corygrant/WiperModule/PDF/WiperModule_v1_Schem.pdf

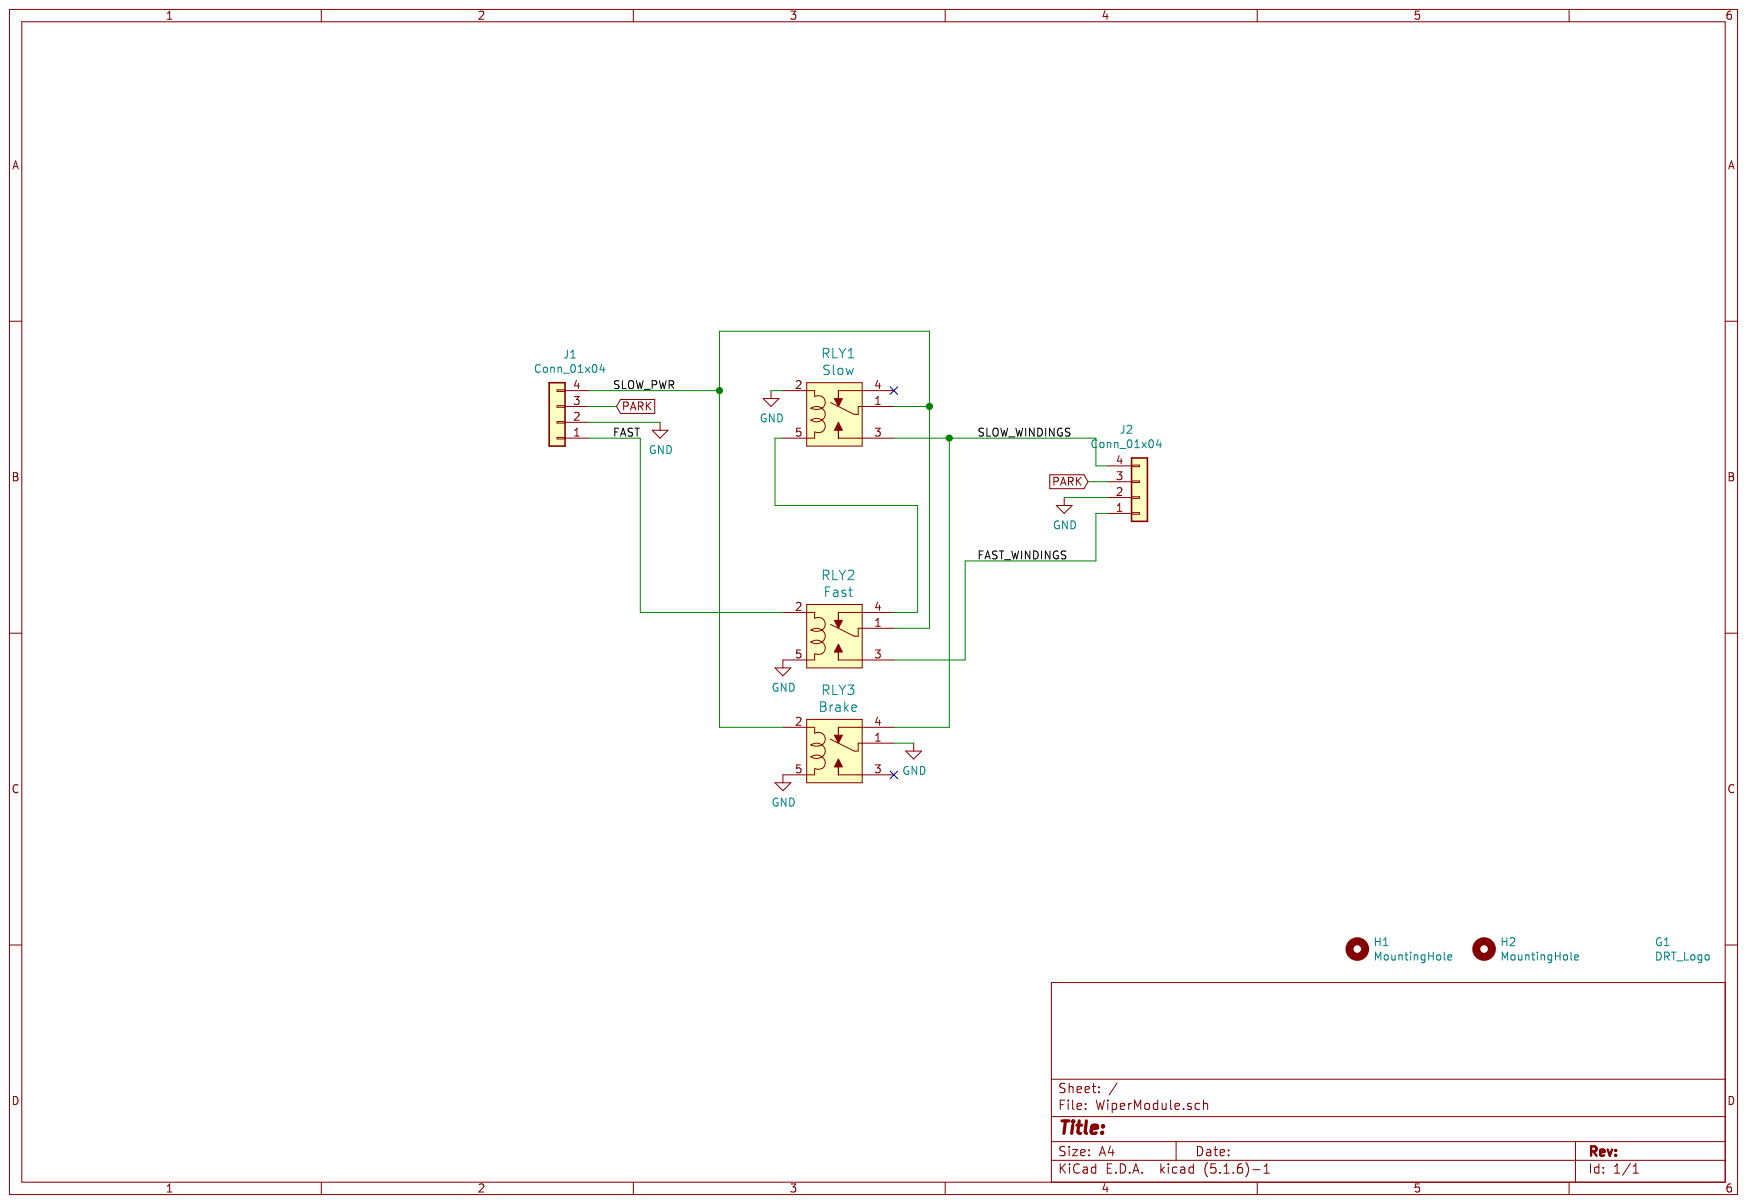
[picture p3: page 1]
