corygrant/WiperModule/WiperModule/WiperModule.kicad_pcb

## KiCad design WiperModule/WiperModule.kicad_pcb (2024-09-06)

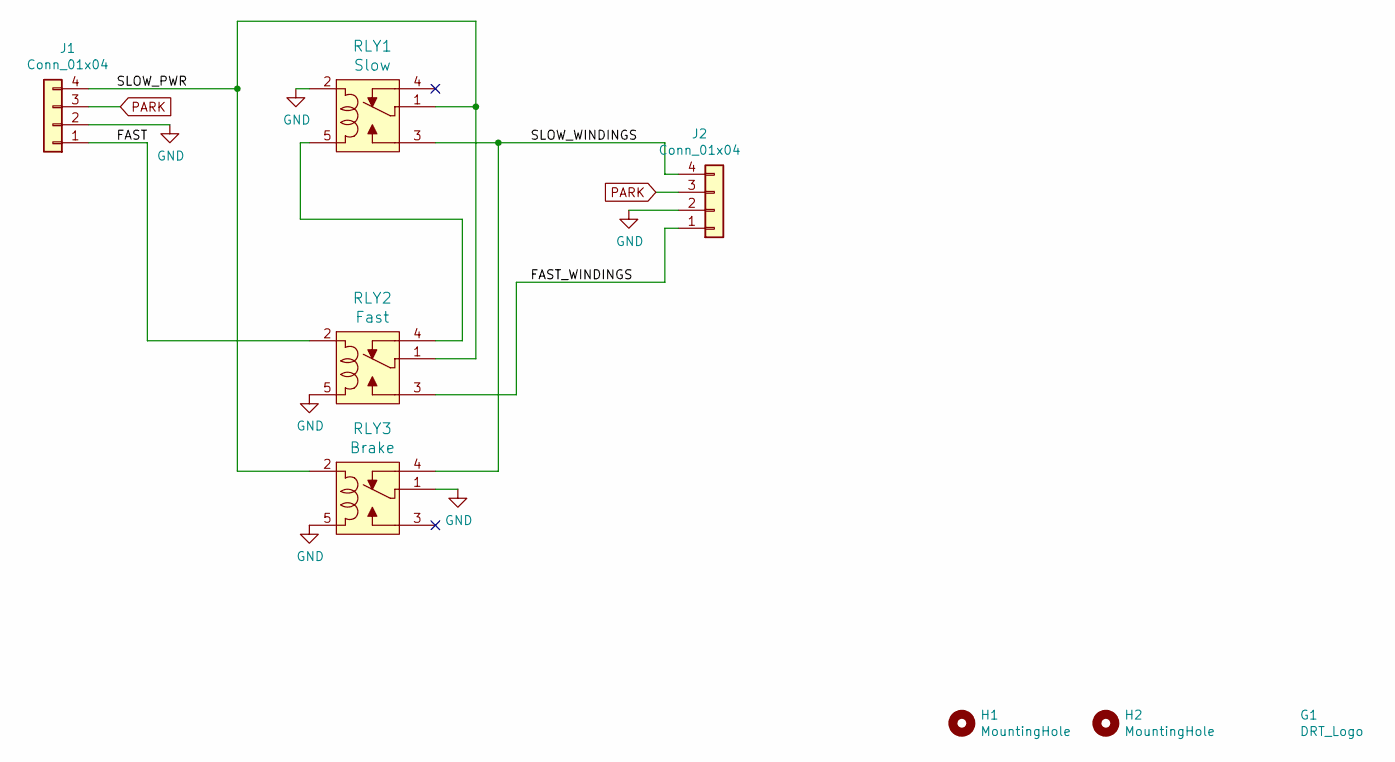
[picture p4: schematic WiperModule.kicad_sch]

Parts:
G1: DRT_Logo; DRTLogo
H1, H2: MountingHole; MountingHole_4.3mm_M4_DIN965_Pad
J1, J2: Conn_01x04; DTF13-4P; Digi-Key_PN 1734-1646-ND
RLY1: Slow; Relay_JSM1-12V-5; MPN JSM1-12V-5; Digi-Key_PN Z2617-ND
RLY2: Fast; Relay_JSM1-12V-5; MPN JSM1-12V-5; Digi-Key_PN Z2617-ND
RLY3: Brake; Relay_JSM1-12V-5; MPN JSM1-12V-5; Digi-Key_PN Z2617-ND

Connections:
/FAST: J1.1, RLY2.2
/FAST_WINDINGS: J2.1, RLY2.3 (NO)
/SLOW_PWR: J1.4, RLY1.1 (COM), RLY2.1 (COM), RLY3.2
/SLOW_WINDINGS: J2.4, RLY1.3 (NO), RLY3.4 (NC)
GND: J1.2, J2.2, RLY1.2, RLY2.5, RLY3.1 (COM), RLY3.5
unnamed: RLY1.5, RLY2.4 (NC)
PARK: J1.3, J2.3

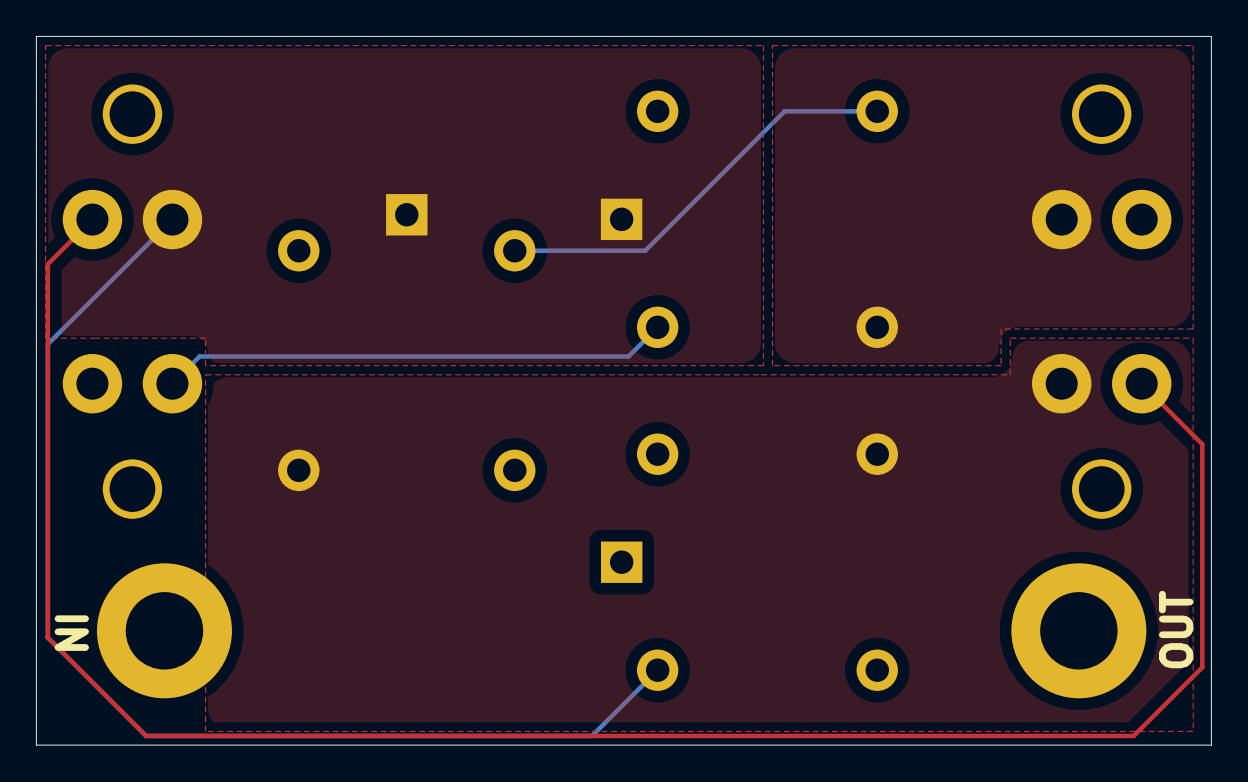
[picture p5: board WiperModule.kicad_pcb from above]

Board: 2 copper layers, 65.3 x 39.4 mm, 8 parts (1 on the bottom side), 7 nets.
