corygrant/WiperModule/(commit log)

2021-04-10 Reorganizing files
    [WiperModule-B_Cu.gbl, WiperModule-B_Mask.gbs, WiperModule-B_SilkS.gbo, WiperModule-Edge_Cuts.gm1, WiperModule-F_Cu.gtl, WiperModule-F_Mask.gts, WiperModule-F_SilkS.gto, WiperModule.drl]
2024-04-03 Updated to latest Kicad, images and added gitignore
    [WiperModule.kicad_pcb, WiperModule.kicad_sch]
2024-09-06 Update to Kicad 8
    [WiperModule.kicad_pcb, WiperModule.kicad_sch]
